dvhai08/Hawaco_datalogger/01.Docs/Other/ota_note.txt

Step1 :
chèn 16 bytes md5 vào cuối cùng firmware
step2: chèn header
DTG01 : 44544730310000000000000000000000
DTG02 : 44544730320000000000000000000000
Lưu ý : cài đặt version hardware trên web trùng với trên device
