dvhai08/Hawaco_datalogger/01.Docs/Other/9ddd6996b74a4114185b.jpg

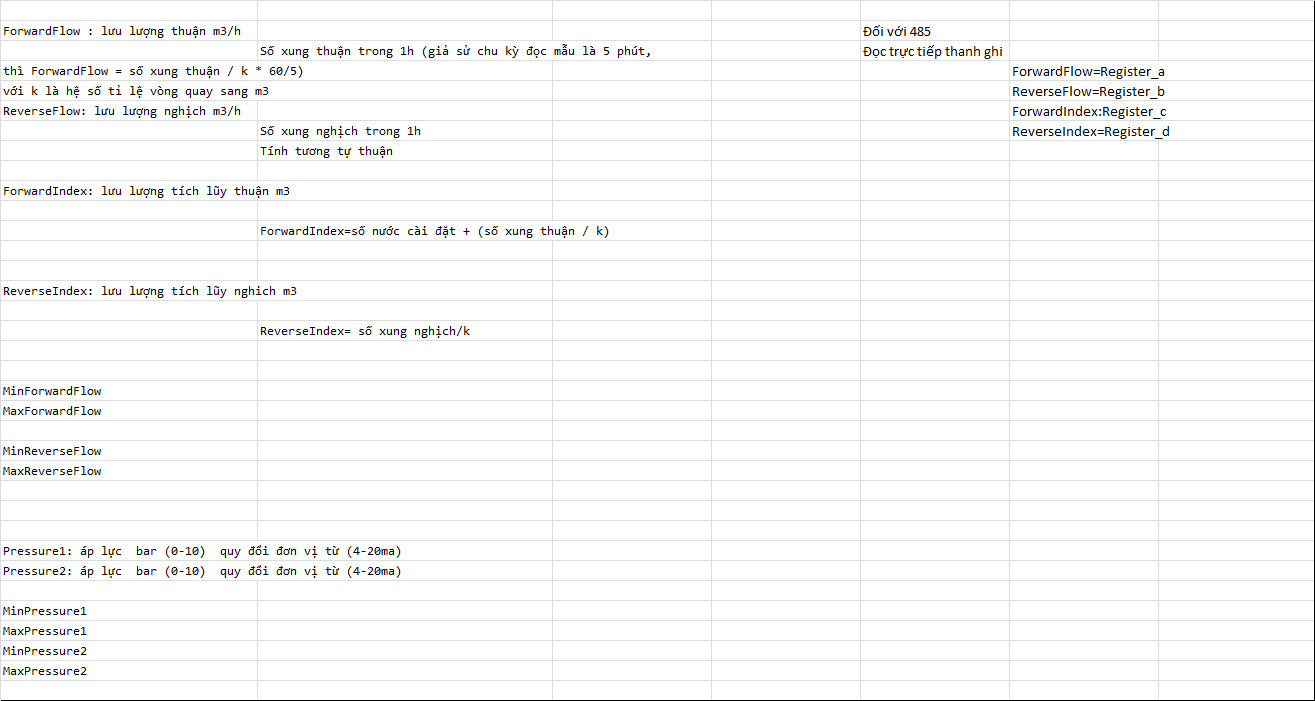
01.Docs/Other/9ddd6996b74a4114185b.jpg
