dvhai08/Hawaco_datalogger/(list of files, drawings)

Other design files:
03.Hardware/DT-G1/HAWACO_DATALOGER_DT-G1_V2.0 (6-12-2021 11-16-03 AM)/Prj/HAWACO_DATALOGER_DT-G1_V2.0.PrjPcb
03.Hardware/DT-G1/HAWACO_DATALOGER_DT-G1_V2.0 (6-12-2021 11-16-03 AM)/Sch/00. Root.SchDoc
03.Hardware/DT-G1/HAWACO_DATALOGER_DT-G1_V2.0 (6-12-2021 11-16-03 AM)/Sch/01. Cover.SchDoc
03.Hardware/DT-G1/HAWACO_DATALOGER_DT-G1_V2.0 (6-12-2021 11-16-03 AM)/Sch/02. Block diagram.SchDoc
03.Hardware/DT-G1/HAWACO_DATALOGER_DT-G1_V2.0 (6-12-2021 11-16-03 AM)/Sch/03. Power.SchDoc
03.Hardware/DT-G1/HAWACO_DATALOGER_DT-G1_V2.0 (6-12-2021 11-16-03 AM)/Sch/04. MCU + ANALOG.SchDoc
03.Hardware/DT-G1/HAWACO_DATALOGER_DT-G1_V2.0 (6-12-2021 11-16-03 AM)/Sch/05. 4G Module.SchDoc
03.Hardware/HAWACO_DATALOGER_DT-G2_V1.0 (6-12-2021 11-17-38 AM)/Prj/HAWACO_DATALOGER_DT-G2_V1.0.PrjPcb
03.Hardware/HAWACO_DATALOGER_DT-G2_V1.0 (6-12-2021 11-17-38 AM)/Sch/00. Root.SchDoc
03.Hardware/HAWACO_DATALOGER_DT-G2_V1.0 (6-12-2021 11-17-38 AM)/Sch/01. Cover.SchDoc
03.Hardware/HAWACO_DATALOGER_DT-G2_V1.0 (6-12-2021 11-17-38 AM)/Sch/03. Power.SchDoc
03.Hardware/HAWACO_DATALOGER_DT-G2_V1.0 (6-12-2021 11-17-38 AM)/Sch/04. MCU + ANALOG.SchDoc
03.Hardware/HAWACO_DATALOGER_DT-G2_V1.0 (6-12-2021 11-17-38 AM)/Sch/05. 4G Module.SchDoc
03.Hardware/HAWACO_DATALOGER_DT-G2_V1.0.2 (7-20-2021 3-44-25 PM)/Prj/HAWACO_DATALOGER_DT-G2_V1.0.2.PrjPcb
03.Hardware/HAWACO_DATALOGER_DT-G2_V1.0.2 (7-20-2021 3-44-25 PM)/Sch/00. Root.SchDoc
03.Hardware/HAWACO_DATALOGER_DT-G2_V1.0.2 (7-20-2021 3-44-25 PM)/Sch/01. Cover.SchDoc
03.Hardware/HAWACO_DATALOGER_DT-G2_V1.0.2 (7-20-2021 3-44-25 PM)/Sch/03. Power.SchDoc
03.Hardware/HAWACO_DATALOGER_DT-G2_V1.0.2 (7-20-2021 3-44-25 PM)/Sch/04. MCU + ANALOG.SchDoc
03.Hardware/HAWACO_DATALOGER_DT-G2_V1.0.2 (7-20-2021 3-44-25 PM)/Sch/05. 4G Module.SchDoc
03.Hardware/HAWACO_DATALOGER_DT-G2_V1.0.3 (8-11-2021 3-12-40 PM)/Pcb/HAWACO_DATALOGER_DT-G2_PANEL.PcbDoc
03.Hardware/HAWACO_DATALOGER_DT-G2_V1.0.3 (8-11-2021 3-12-40 PM)/Prj/HAWACO_DATALOGER_DT-G2_V1.0.3.PrjPcb
03.Hardware/HAWACO_DATALOGER_DT-G2_V1.0.3 (8-11-2021 3-12-40 PM)/Sch/00. Root.SchDoc
03.Hardware/HAWACO_DATALOGER_DT-G2_V1.0.3 (8-11-2021 3-12-40 PM)/Sch/01. Cover.SchDoc
03.Hardware/HAWACO_DATALOGER_DT-G2_V1.0.3 (8-11-2021 3-12-40 PM)/Sch/02. Block diagram.SchDoc
03.Hardware/HAWACO_DATALOGER_DT-G2_V1.0.3 (8-11-2021 3-12-40 PM)/Sch/03. Power.SchDoc
03.Hardware/HAWACO_DATALOGER_DT-G2_V1.0.3 (8-11-2021 3-12-40 PM)/Sch/04. MCU + ANALOG.SchDoc
03.Hardware/HAWACO_DATALOGER_DT-G2_V1.0.3 (8-11-2021 3-12-40 PM)/Sch/05. 4G Module.SchDoc
