dvhai08/Hawaco_datalogger/02.Firmware/src/inc/hardware.h

#ifndef __HARDWARE_H__
#define __HARDWARE_H__

#if 1
#include "main.h"
#ifndef DTG02V2
#define GSM_PWR_EN(x)			{	if (x) \
										LL_GPIO_SetOutputPin(GSM_EN_GPIO_Port, GSM_EN_Pin);	\
									else	\
										LL_GPIO_ResetOutputPin(GSM_EN_GPIO_Port, GSM_EN_Pin);	\
								}
#else
#define GSM_PWR_EN(x)			{	if (x) \
									{	\
										LL_GPIO_SetOutputPin(GSM_EN_GPIO_Port, GSM_EN_Pin);	\
										LL_GPIO_SetOutputPin(SYS_4V2_EN_GPIO_Port, SYS_4V2_EN_Pin);	\
									}	\
									else	\
									{	\
										LL_GPIO_ResetOutputPin(GSM_EN_GPIO_Port, GSM_EN_Pin);	\
									}	\
								}
#endif
#define GSM_PWR_RESET(x)		{	if (x) \
										LL_GPIO_SetOutputPin(GSM_RESET_GPIO_Port, GSM_RESET_Pin);	\
									else	\
										LL_GPIO_ResetOutputPin(GSM_RESET_GPIO_Port, GSM_RESET_Pin);	\
								}

#define GSM_PWR_KEY(x)			{	if (x) \
										LL_GPIO_SetOutputPin(GSM_PWR_KEY_GPIO_Port, GSM_PWR_KEY_Pin);	\
									else	\
										LL_GPIO_ResetOutputPin(GSM_PWR_KEY_GPIO_Port, GSM_PWR_KEY_Pin);	\
								}		

#define GSM_IS_PWR_EN()			LL_GPIO_IsOutputPinSet(GSM_EN_GPIO_Port, GSM_EN_Pin) ? 1 : 0

#define GSM_UART				0
#define RS485_UART				1

#ifdef HW_VERSION_0
#define LED1(x)             	{	if (x) \
										LL_GPIO_ResetOutputPin(LED1_GPIO_Port, LED1_Pin);	\
									else	\
										LL_GPIO_SetOutputPin(LED1_GPIO_Port, LED1_Pin);	\
								}		

#define LED2(x)             	{	if (x) \
										LL_GPIO_ResetOutputPin(LED2_GPIO_Port, LED2_Pin);	\
									else	\
										LL_GPIO_SetOutputPin(LED2_GPIO_Port, LED2_Pin);	\
									}	
#else
#define LED1(x)             	{	if (x) \
                                        LL_GPIO_SetOutputPin(LED1_GPIO_Port, LED1_Pin);	\
                                    else	\
                                        LL_GPIO_ResetOutputPin(LED1_GPIO_Port, LED1_Pin);	\
                                }		

#define LED2(x)             	{	if (x) \
										LL_GPIO_SetOutputPin(LED2_GPIO_Port, LED2_Pin);	\
									else	\
										LL_GPIO_ResetOutputPin(LED2_GPIO_Port, LED2_Pin);	\
                                }	
#define LED1_TOGGLE()			LL_GPIO_TogglePin(LED1_GPIO_Port, LED1_Pin)
#define LED2_TOGGLE()			LL_GPIO_TogglePin(LED2_GPIO_Port, LED2_Pin)							
#endif
				
#define TRANS_OUTPUT(x)      	{	if (x) \
										LL_GPIO_ResetOutputPin(TRANS_OUTPUT_GPIO_Port, TRANS_OUTPUT_Pin);	\
									else	\
										LL_GPIO_SetOutputPin(TRANS_OUTPUT_GPIO_Port, TRANS_OUTPUT_Pin);	\
								}	                                
							
#define TRANS_1_OUTPUT(x)      	{	if (x) \
										LL_GPIO_ResetOutputPin(TRANS_OUT1_GPIO_Port, TRANS_OUT1_Pin);	\
									else	\
										LL_GPIO_SetOutputPin(TRANS_OUT1_GPIO_Port, TRANS_OUT1_Pin);	\
								}	

#define TRANS_2_OUTPUT(x)      	{	if (x) \
										LL_GPIO_ResetOutputPin(TRANS_OUT2_GPIO_Port, TRANS_OUT2_Pin);	\
									else	\
										LL_GPIO_SetOutputPin(TRANS_OUT2_GPIO_Port, TRANS_OUT2_Pin);	\
								}	

#define TRANS_3_OUTPUT(x)      	{	if (x) \
										LL_GPIO_ResetOutputPin(TRANS_OUT3_GPIO_Port, TRANS_OUT3_Pin);	\
									else	\
										LL_GPIO_SetOutputPin(TRANS_OUT3_GPIO_Port, TRANS_OUT3_Pin);	\
								}	

#define TRANS_4_OUTPUT(x)      	{	if (x) \
										LL_GPIO_ResetOutputPin(TRANS_OUT4_GPIO_Port, TRANS_OUT4_Pin);	\
									else	\
										LL_GPIO_SetOutputPin(TRANS_OUT4_GPIO_Port, TRANS_OUT4_Pin);	\
								}								

#define TRANS_1_TOGGLE()      	{   \
										LL_GPIO_TogglePin(TRANS_OUT1_GPIO_Port, TRANS_OUT1_Pin);	\
								}	

#define TRANS_2_TOGGLE()      	{   \
										LL_GPIO_TogglePin(TRANS_OUT2_GPIO_Port, TRANS_OUT2_Pin);	\
								}	

#define TRANS_3_TOGGLE()      	{   \
										LL_GPIO_TogglePin(TRANS_OUT3_GPIO_Port, TRANS_OUT3_Pin);	\
								}	

#define TRANS_4_TOGGLE()      	{   \
										LL_GPIO_TogglePin(TRANS_OUT4_GPIO_Port, TRANS_OUT4_Pin);	\
								}	
                                
#define TRANS_IS_OUTPUT_HIGH()		(LL_GPIO_IsOutputPinSet(TRANS_OUTPUT_GPIO_Port, TRANS_OUTPUT_Pin) ? 0 : 1)
#define TRANS_1_IS_OUTPUT_HIGH()	(LL_GPIO_IsOutputPinSet(TRANS_OUT1_GPIO_Port, TRANS_OUT1_Pin) ? 0 : 1)
#define TRANS_2_IS_OUTPUT_HIGH()	(LL_GPIO_IsOutputPinSet(TRANS_OUT2_GPIO_Port, TRANS_OUT2_Pin) ? 0 : 1)

#define TRANS_3_IS_OUTPUT_HIGH()	(LL_GPIO_IsOutputPinSet(TRANS_OUT3_GPIO_Port, TRANS_OUT3_Pin) ? 0 : 1)
#define TRANS_4_IS_OUTPUT_HIGH()	(LL_GPIO_IsOutputPinSet(TRANS_OUT4_GPIO_Port, TRANS_OUT4_Pin) ? 0 : 1)
								
#define ENABLE_NTC_POWER(x)     {	if (x) \
										LL_GPIO_SetOutputPin(VNTC_GPIO_Port, VNTC_Pin);	\
									else	\
										LL_GPIO_ResetOutputPin(VNTC_GPIO_Port, VNTC_Pin);	\
								}		

#define NTC_IS_POWERED()		LL_GPIO_IsOutputPinSet(VNTC_GPIO_Port, VNTC_Pin)						
								
								
#define ENABLE_INPUT_4_20MA_POWER(x)	{	if (x) \
												LL_GPIO_ResetOutputPin(EN_4_20MA_IN_GPIO_Port, EN_4_20MA_IN_Pin);	\
											else	\
												LL_GPIO_SetOutputPin(EN_4_20MA_IN_GPIO_Port, EN_4_20MA_IN_Pin);	\
										}

#define INPUT_POWER_4_20_MA_IS_ENABLE()       (LL_GPIO_IsOutputPinSet(EN_4_20MA_IN_GPIO_Port, EN_4_20MA_IN_Pin) ? 0 : 1)
         
#ifdef DTG01										
    #define ENABLE_OUTPUT_4_20MA_POWER(x)	{	if (x) \
                                                    LL_GPIO_ResetOutputPin(ENABLE_OUTPUT_4_20MA_GPIO_Port, ENABLE_OUTPUT_4_20MA_Pin);	\
                                                else	\
                                                    LL_GPIO_SetOutputPin(ENABLE_OUTPUT_4_20MA_GPIO_Port, ENABLE_OUTPUT_4_20MA_Pin);	\
                                            }	
#endif  // DTG01

#if defined(DTG02V2)  
                                        
    // 4.2V provice power for GSM and 4-20mA ouput
    #define ENABLE_OUTPUT_4_20MA_POWER(x)	{	if (x) \
                                                    LL_GPIO_SetOutputPin(SYS_4V2_EN_GPIO_Port, SYS_4V2_EN_Pin);	\
                                                else if (gsm_data_layer_is_module_sleeping())	\
                                                    LL_GPIO_ResetOutputPin(SYS_4V2_EN_GPIO_Port, SYS_4V2_EN_Pin);	\
                                            }	
    #define ENABLE_SYS_4V2(x)				{	if (x) \
                                                    LL_GPIO_SetOutputPin(SYS_4V2_EN_GPIO_Port, SYS_4V2_EN_Pin);	\
                                                else	\
                                                    LL_GPIO_ResetOutputPin(SYS_4V2_EN_GPIO_Port, SYS_4V2_EN_Pin);	\
                                            }	
#endif // defined(DTG02V2) 
             
#if defined(DTG02)
                                        
    // 4.2V provice power for GSM and 4-20mA ouput
    #define ENABLE_OUTPUT_4_20MA_POWER(x)	{	if (x) \
                                                    LL_GPIO_SetOutputPin(ENABLE_OUTPUT_4_20MA_GPIO_Port, ENABLE_OUTPUT_4_20MA_Pin);	\
                                                else if (gsm_data_layer_is_module_sleeping())	\
                                                    LL_GPIO_ResetOutputPin(ENABLE_OUTPUT_4_20MA_GPIO_Port, ENABLE_OUTPUT_4_20MA_Pin);	\
                                            }	
    #define ENABLE_SYS_4V2(x)				{	if (x) \
                                                    LL_GPIO_SetOutputPin(ENABLE_OUTPUT_4_20MA_GPIO_Port, ENABLE_OUTPUT_4_20MA_Pin);	\
                                                else	\
                                                    LL_GPIO_ResetOutputPin(ENABLE_OUTPUT_4_20MA_GPIO_Port, ENABLE_OUTPUT_4_20MA_Pin);	\
                                            }	
#endif // defined(DTG02)                                          
                                            


#if defined(DTG02V3)  
                                        
    // 4.2V provice power for GSM and 4-20mA ouput
    #define ENABLE_OUTPUT_4_20MA_POWER(x)	{	if (x) \
                                                    LL_GPIO_ResetOutputPin(EN_4_20MA_OUT_POWER_GPIO_Port, EN_4_20MA_OUT_POWER_Pin);	\
                                                else	\
                                                    LL_GPIO_SetOutputPin(EN_4_20MA_OUT_POWER_GPIO_Port, EN_4_20MA_OUT_POWER_Pin);	\
                                            }
        
    #define ENABLE_SYS_4V2(x)				{	if (x) \
                                                    LL_GPIO_SetOutputPin(SYS_5V_EN_GPIO_Port, SYS_5V_EN_Pin);	\
                                                else	\
                                                    LL_GPIO_ResetOutputPin(SYS_5V_EN_GPIO_Port, SYS_5V_EN_Pin);	\
                                            }	
#endif // defined(DTG02V3) 
										
#define RS485_POWER_EN(x)				{	if (x) \
												LL_GPIO_ResetOutputPin(RS485_EN_GPIO_Port, RS485_EN_Pin);	\
											else	\
												LL_GPIO_SetOutputPin(RS485_EN_GPIO_Port, RS485_EN_Pin);	\
										}	
#define RS485_DIR_TX()                  {   \
                                            LL_GPIO_SetOutputPin(RS485_DIR_GPIO_Port, RS485_DIR_Pin);     \
                                        }
   
#define RS485_DIR_RX()                  {   \
                                            LL_GPIO_ResetOutputPin(RS485_DIR_GPIO_Port, RS485_DIR_Pin);     \
                                        }                                        
#define RS485_GET_DIRECTION()               LL_GPIO_IsOutputPinSet(RS485_DIR_GPIO_Port, RS485_DIR_Pin)
#endif

#ifdef DTG02
#define BUZZER(x)                       {	if (x) \
												LL_GPIO_ResetOutputPin(BUZZER_GPIO_Port, BUZZER_Pin);	\
											else	\
												LL_GPIO_SetOutputPin(BUZZER_GPIO_Port, BUZZER_Pin);	\
										}   
#endif                                        
                                        
#define ADC_NUMBER_OF_CONVERSION_TIMES		10
//#define V_OFFSET_4_20MA_CHANNEL_0_MV        1
#define ADC_VBAT_RESISTOR_DIV				2
#define ADC_VIN_RESISTOR_DIV				7911
#define ADC_VI_ANALOG_INPUT_RESISTOR_DIV    7667
                                        
#ifdef DTG02
#define ADC_CHANNEL_DMA_COUNT				9
//#define ADC_VREF							3300

#define V_INPUT_3_4_20MA_CHANNEL_INDEX		0
#define VIN_24V_CHANNEL_INDEX				1
#define V_INPUT_2_4_20MA_CHANNEL_INDEX		2
#define V_INPUT_1_4_20MA_CHANNEL_INDEX		3
#define V_INPUT_0_4_20MA_CHANNEL_INDEX		4
#define VBAT_CHANNEL_INDEX					5
#define V_NTC_TEMP_CHANNEL_INDEX				6
#define V_INTERNAL_CHIP_TEMP_CHANNEL_INDEX  7
#define V_REF_CHANNEL_INDEX                 8
//#define V_OFFSET_4_20MA_CHANNEL_1_MV        1
//#define V_OFFSET_4_20MA_CHANNEL_2_MV        1
//#define V_OFFSET_4_20MA_CHANNEL_3_MV        1
#endif

#ifdef DTG02V2
#define ADC_CHANNEL_DMA_COUNT				9
//#define ADC_VREF							3300

#define V_INPUT_3_4_20MA_CHANNEL_INDEX		5
#define VIN_24V_CHANNEL_INDEX				0
#define V_INPUT_2_4_20MA_CHANNEL_INDEX		1
#define V_INPUT_1_4_20MA_CHANNEL_INDEX		2
#define V_INPUT_0_4_20MA_CHANNEL_INDEX		3
#define VBAT_CHANNEL_INDEX					4
#define V_NTC_TEMP_CHANNEL_INDEX		    6
#define V_INTERNAL_CHIP_TEMP_CHANNEL_INDEX  7
#define V_REF_CHANNEL_INDEX                 8
#endif /* DTG02V2 */

#ifdef DTG02V3
#define ADC_CHANNEL_DMA_COUNT				11
#define V_ANALOG_0_INPUT_INDEX              1
#define V_ANALOG_1_INPUT_INDEX              5
#define VIN_24V_CHANNEL_INDEX				0

#define V_INPUT_3_4_20MA_CHANNEL_INDEX		7
#define V_INPUT_2_4_20MA_CHANNEL_INDEX		2
#define V_INPUT_1_4_20MA_CHANNEL_INDEX		3
#define V_INPUT_0_4_20MA_CHANNEL_INDEX		4

#define VBAT_CHANNEL_INDEX					6
#define V_NTC_TEMP_CHANNEL_INDEX		    8

#define V_INTERNAL_CHIP_TEMP_CHANNEL_INDEX  9
#define V_REF_CHANNEL_INDEX                 10
#endif /* DTG02V3 */

#ifdef DTG01
#define ADC_CHANNEL_DMA_COUNT				6
//#define ADC_VREF							3300

#define VBAT_CHANNEL_INDEX						0
#define V_INPUT_0_4_20MA_CHANNEL_INDEX			1
#define VIN_24V_CHANNEL_INDEX					2	
#define V_NTC_TEMP_CHANNEL_INDEX				3
#define V_INTERNAL_CHIP_TEMP_CHANNEL_INDEX  	4
#define V_REF_CHANNEL_INDEX						5
#endif

#define VREF_OFFSET_MV							80
#define ADC_INPUT_4_20MA_GAIN               	(50.0f)   



#if defined(DTG02) || defined(DTG02V2) || defined(DTG02V3)
    #define NUMBER_OF_INPUT_4_20MA						4
    #define MEASURE_NUMBER_OF_WATER_METER_INPUT			2
    
    #ifdef DTG02V3
        #define NUMBER_OF_OUTPUT_ON_OFF						2
    #else
        #define NUMBER_OF_OUTPUT_ON_OFF						4
    #endif
    
    #define NUMBER_OF_OUTPUT_4_20MA                     1
    
    #if defined(DTG02)
        #define MEASURE_INPUT_PORT_1						0
        #define MEASURE_INPUT_PORT_2		                1
        #define	NUMBER_OF_INPUT_ON_OFF						4
    #elif defined(DTG02V2)
        #define MEASURE_INPUT_PORT_1						1
        #define MEASURE_INPUT_PORT_2		                0
        #define	NUMBER_OF_INPUT_ON_OFF						4
    #elif defined(DTG02V3)
        #define MEASURE_INPUT_PORT_1						0
        #define MEASURE_INPUT_PORT_2		                1
        #define	NUMBER_OF_INPUT_ON_OFF						2
    #endif
#else   // DTG01
    #define MEASURE_INPUT_PORT_1						0
    #define MEASURE_INPUT_PORT_2		                1
    #define	NUMBER_OF_OUTPUT_ON_OFF						1
    #define NUMBER_OF_INPUT_4_20MA						1
    #define NUMBER_OF_OUTPUT_4_20MA                     1
    #define MEASURE_NUMBER_OF_WATER_METER_INPUT			1		
#endif // defined(DTG02) || defined(DTG02V2) || defined(DTG02V3)

#define MEASURE_INPUT_NEW_DATA_TYPE_PWM_PIN         0
#define MEASURE_INPUT_NEW_DATA_TYPE_DIR_PIN         1
#define MEASUREMENT_MAX_MSQ_IN_RAM                  1

#define MEASUREMENT_QUEUE_STATE_IDLE                0
#define MEASUREMENT_QUEUE_STATE_PENDING             1       // Dang cho de doc
#define MEASUREMENT_QUEUE_STATE_PROCESSING          2       // Da doc nhung dang xu li, chua release thanh free

#define RS485_DATA_TYPE_INT16						0
#define RS485_DATA_TYPE_INT32						1
#define RS485_DATA_TYPE_FLOAT						2
#define RS485_MAX_SLAVE_ON_BUS						1
#define RS485_MAX_REGISTER_SUPPORT					4
#define RS485_MAX_SUB_REGISTER						4
#define RS485_REGISTER_ADDR_TOP						50000

#define APP_EEPROM_VALID_FLAG						0x15234519
#define APP_EEPROM_SIZE								(6*1024)

#define APP_EEPROM_METER_MODE_DISABLE				0
#define APP_EEPROM_METER_MODE_PWM_PLUS_DIR_MIN		1 // Meter mode 0 : PWM++, DIR--
#define APP_EEPROM_METER_MODE_ONLY_PWM				2 // Meter mode 1 : PWM++
#define APP_EEPROM_METER_MODE_PWM_F_PWM_R			3 // Meter mode 2 : PWM_F & PWM_R
#define APP_EEPROM_METER_MODE_MAX_ELEMENT           2
#define APP_EEPROM_MAX_PHONE_LENGTH                 16
#define APP_EEPROM_MAX_SERVER_ADDR_LENGTH           64
#define APP_EEPROM_MAX_NUMBER_OF_SERVER				2
#define APP_EEPROM_MAIN_SERVER_ADDR_INDEX			0
#define APP_EEPROM_ALTERNATIVE_SERVER_ADDR_INDEX	(APP_EEPROM_MAX_NUMBER_OF_SERVER-1)

#if defined(DTG02) || defined(DTG02V2) || defined(DTG02V3)
    #define APP_EEPROM_NB_OF_INPUT_4_20MA               4
#else
    #define APP_EEPROM_NB_OF_INPUT_4_20MA               1
#endif // defined(DTG02) || defined(DTG02V2) || defined(DTG02V3)

#define APP_EEPROM_MAX_UNIT_NAME_LENGTH				6

#define APP_FLASH_VALID_DATA_KEY                    0x12345678               
#ifdef DTG01
#define APP_FLASH_NB_OFF_4_20MA_INPUT               2
#define APP_FLASH_NB_OF_METER_INPUT                 1
#else
#define APP_FLASH_NB_OFF_4_20MA_INPUT               NUMBER_OF_INPUT_4_20MA
#define APP_FLASH_NB_OF_METER_INPUT                 APP_EEPROM_METER_MODE_MAX_ELEMENT
#endif
#define APP_FLASH_RS485_MAX_SIZE                    (RS485_MAX_REGISTER_SUPPORT)
#define APP_SPI_FLASH_SIZE						    (1024*1024)
#define APP_FLASH_DONT_NEED_TO_SEND_TO_SERVER_FLAG  0xA5A5A5A5
//#define APP_FLASH_DATA_HEADER_KEY                   0x9813567A

#define CRC32_SIZE		4

#define INPUT_ON_OFF_0()			(LL_GPIO_IsInputPinSet(OPTOIN1_GPIO_Port, OPTOIN1_Pin) ? 1 : 0)
#define INPUT_ON_OFF_1()			(LL_GPIO_IsInputPinSet(OPTOIN2_GPIO_Port, OPTOIN2_Pin) ? 1 : 0)
#define INPUT_ON_OFF_2()			(LL_GPIO_IsInputPinSet(OPTOIN3_GPIO_Port, OPTOIN3_Pin) ? 1 : 0)
#define INPUT_ON_OFF_3()			(LL_GPIO_IsInputPinSet(OPTOIN4_GPIO_Port, OPTOIN4_Pin) ? 1 : 0)

#define FLOW_INVALID_VALUE                  (-1.0f)
#define INPUT_4_20MA_INVALID_VALUE          (-1.0f)
#define INPUT_485_INVALID_FLOAT_VALUE       (-1.0f)    
#define INPUT_485_INVALID_INT_VALUE         (-1)    

#define FAKE_MIN_MAX_DATA                   (0)
#define USE_SYNC_DRV                        (0)

#define MEASURE_SUM_MB_FLOW                 0

typedef union
{
	struct
	{
		uint8_t valid : 1;
		uint8_t type : 7;
	} __attribute__((packed)) name;
	uint8_t raw;
} __attribute__((packed)) measure_input_rs485_data_type_t;

typedef union
{
    float float_val;
    int32_t int32_val;
    uint8_t raw[4];
} __attribute__((packed)) measure_input_rs485_float_uint32_t;

typedef struct
{
	uint16_t register_addr;
	measure_input_rs485_float_uint32_t value;
	measure_input_rs485_data_type_t data_type;
	uint8_t unit[APP_EEPROM_MAX_UNIT_NAME_LENGTH];
	int8_t read_ok;
} __attribute__((packed)) measure_input_rs485_sub_register_t;

typedef union
{
    int32_t type_int32;
    float type_float;
    uint8_t raw[4];
} __attribute__((packed)) min_max_485_type_t;
typedef struct
{
    min_max_485_type_t min_forward_flow;
    min_max_485_type_t max_forward_flow;
    min_max_485_type_t min_reverse_flow;
    min_max_485_type_t max_reverse_flow;
    min_max_485_type_t reverse_flow;
    min_max_485_type_t forward_flow;
#if MEASURE_SUM_MB_FLOW
    min_max_485_type_t forward_flow_sum;
    min_max_485_type_t reverse_flow_sum;
#endif
    min_max_485_type_t net_volume_fw;
    min_max_485_type_t net_volume_reverse;
    min_max_485_type_t net_speed;
    min_max_485_type_t net_index;
    uint8_t valid;
} __attribute__((packed)) measure_input_rs485_min_max_t;
typedef struct
{
	measure_input_rs485_sub_register_t sub_register[RS485_MAX_SUB_REGISTER];
    measure_input_rs485_min_max_t min_max;
    uint16_t fw_flow_reg;
    uint16_t reserve_flow_reg;
    uint16_t net_totalizer_fw_reg;
    uint16_t net_totalizer_reverse_reg;
    uint16_t net_totalizer_reg;
    uint8_t slave_addr;
} __attribute__((packed)) measure_input_modbus_register_t;

typedef struct
{
    float fw_flow_min;
    float fw_flow_max;
    float reserve_flow_min;
    float reserve_flow_max;
    uint32_t fw_flow_first_counter;
    uint32_t reverse_flow_first_counter;
    float fw_flow_sum;
    float reverse_flow_sum;
    uint8_t valid;
} __attribute__((packed)) flow_hour_t;

typedef struct
{
    float input4_20ma_min;
    float input4_20ma_max;
    uint8_t valid;
} __attribute__((packed)) input_4_20ma_min_max_hour_t;

typedef struct
{
	int32_t real_counter;           // gia tri do khi da tinh ca xung am duong
    int32_t reverse_counter;
    int32_t total_forward;
    int32_t total_reverse;
    
    uint32_t fw_flow;               // Toc do quay thuan
    uint32_t reverse_flow;          // Toc do quay nguoc
    
    float flow_speed_forward_agv_cycle_wakeup;             // Trung binh toc do giua 2 lan do 
    float flow_speed_reserve_agv_cycle_wakeup;             // Trung binh toc do giua 2 lan do 
    
    uint32_t total_forward_index;       // So nuoc thuan da tinh khi chia cho k + offset
    uint32_t total_reverse_index;       // so nuoc nghich da tinh sau khi chia cho k (ko co offset)
    
    flow_hour_t flow_avg_cycle_send_web;        // Trung binh toc do giua 2 lan thuc day gui data len web
    
    uint32_t indicator;
	uint16_t k;
	uint8_t mode;
	uint8_t cir_break;
} __attribute__((packed)) measure_input_counter_t;

typedef struct
{
    uint32_t current_ma_mil_10;		// 4ma =>> 400
    int32_t adc_mv;					    // adc voltage
} input_4_20ma_lookup_t;

typedef struct
{
	uint32_t round_per_sec_max;
	uint32_t round_per_sec_min;
} __attribute__((packed)) speed_limit_t;

typedef struct
{
	uint32_t tick;
	uint32_t isr_type;
} pulse_irq_t;

static const input_4_20ma_lookup_t lookup_table_4_20ma_input[] =
{
    {  0,        400      },
    {  400,      490    },
    {  500,      591    },  
    {  600,      688    },   
    {  710,      800    },     
    {  800,      890    },    
    {  900,      992    },    
    {  1100,     1098   },  
    {  1290,     1385   },    
    {  1525,     1617   },     
    {  1823,     1915   },     
    {  2000,     2100   },
};
                                  
                                  
#endif /* __HARDWARE_H__ */
