dvhai08/Hawaco_datalogger/02.Firmware/DTG02_V3/Core/Src/adc.c

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
/* Includes ------------------------------------------------------------------*/
#include "adc.h"

/* USER CODE BEGIN 0 */
#include "app_debug.h"
#include <stdbool.h>
#include "lpf.h"
#include "hardware.h"
#include "app_eeprom.h"
#include "math.h"
#include "sys_ctx.h"
#include <string.h>
#include "jig.h"

#define ADC_INPUT_4_20MA_MIN_OFFSET_MV  27
#define ADC_INPUT_4_20MA_MAX_OFFSET_MV  150
#define ADC_VIN_DIODE_OFFSET            220

enum { NUM_CURRENT_LOOK_UP = sizeof(lookup_table_4_20ma_input) / sizeof(input_4_20ma_lookup_t) };

static volatile bool m_adc_started = false;
volatile uint16_t m_adc_raw_data[ADC_CHANNEL_DMA_COUNT];
lpf_data_t m_adc_filterd_data[ADC_CHANNEL_DMA_COUNT];
uint16_t offset_input_4_20ma_mv[APP_EEPROM_NB_OF_INPUT_4_20MA];
static bool m_is_the_first_time = true;

static float look_up_current(uint32_t mv)        // 0.4mA =>> 4, 4mA >> 
{
#if 0
    uint32_t i;
    // Check input min or max
    if (mv <=  lookup_table_4_20ma_input[0].adc_mv)
    {
        return 0;
    }
    else if (mv >=  lookup_table_4_20ma_input[NUM_CURRENT_LOOK_UP-1].adc_mv)
    {
        return 2000;     // 20mA
    }
    
    for (i = 0; i < NUM_CURRENT_LOOK_UP; i++)
    {
        if (mv >= lookup_table_4_20ma_input[i].adc_mv
            && mv < lookup_table_4_20ma_input[i+1].adc_mv)
        {
            uint32_t diff_mv = lookup_table_4_20ma_input[i+1].adc_mv - lookup_table_4_20ma_input[i].adc_mv;
            uint32_t diff_ma = lookup_table_4_20ma_input[i+1].current_ma_mil_10 - lookup_table_4_20ma_input[i].current_ma_mil_10;
            uint32_t ma = lookup_table_4_20ma_input[i].current_ma_mil_10 + diff_ma*(mv - lookup_table_4_20ma_input[i].adc_mv)/diff_mv;
            return ma;
        }
    }

    return 0;
#else
    return mv/ADC_INPUT_4_20MA_GAIN;
#endif
}

/* USER CODE END 0 */

/* ADC init function */
void MX_ADC_Init(void)
{

  /* USER CODE BEGIN ADC_Init 0 */
    if (m_is_the_first_time)
    {
        memset(offset_input_4_20ma_mv, 0, sizeof(offset_input_4_20ma_mv));
    }
  /* USER CODE END ADC_Init 0 */

  LL_ADC_REG_InitTypeDef ADC_REG_InitStruct = {0};
  LL_ADC_InitTypeDef ADC_InitStruct = {0};

  LL_GPIO_InitTypeDef GPIO_InitStruct = {0};

  /* Peripheral clock enable */
  LL_APB2_GRP1_EnableClock(LL_APB2_GRP1_PERIPH_ADC1);

  LL_IOP_GRP1_EnableClock(LL_IOP_GRP1_PERIPH_GPIOC);
  LL_IOP_GRP1_EnableClock(LL_IOP_GRP1_PERIPH_GPIOA);
  /**ADC GPIO Configuration
  PC0   ------> ADC_IN10
  PC1   ------> ADC_IN11
  PC3   ------> ADC_IN13
  PA1   ------> ADC_IN1
  PA4   ------> ADC_IN4
  PA5   ------> ADC_IN5
  PA6   ------> ADC_IN6
  PA7   ------> ADC_IN7
  PC5   ------> ADC_IN15
  */
  GPIO_InitStruct.Pin = ADC_IO_IN0_Pin;
  GPIO_InitStruct.Mode = LL_GPIO_MODE_ANALOG;
  GPIO_InitStruct.Pull = LL_GPIO_PULL_NO;
  LL_GPIO_Init(ADC_IO_IN0_GPIO_Port, &GPIO_InitStruct);

  GPIO_InitStruct.Pin = ADC_VBAT_Pin;
  GPIO_InitStruct.Mode = LL_GPIO_MODE_ANALOG;
  GPIO_InitStruct.Pull = LL_GPIO_PULL_NO;
  LL_GPIO_Init(ADC_VBAT_GPIO_Port, &GPIO_InitStruct);

  GPIO_InitStruct.Pin = ADC_4_20MA_IN4_Pin;
  GPIO_InitStruct.Mode = LL_GPIO_MODE_ANALOG;
  GPIO_InitStruct.Pull = LL_GPIO_PULL_NO;
  LL_GPIO_Init(ADC_4_20MA_IN4_GPIO_Port, &GPIO_InitStruct);

  GPIO_InitStruct.Pin = ADC_24V_Pin;
  GPIO_InitStruct.Mode = LL_GPIO_MODE_ANALOG;
  GPIO_InitStruct.Pull = LL_GPIO_PULL_NO;
  LL_GPIO_Init(ADC_24V_GPIO_Port, &GPIO_InitStruct);

  GPIO_InitStruct.Pin = ADC_IO_IN1_Pin;
  GPIO_InitStruct.Mode = LL_GPIO_MODE_ANALOG;
  GPIO_InitStruct.Pull = LL_GPIO_PULL_NO;
  LL_GPIO_Init(ADC_IO_IN1_GPIO_Port, &GPIO_InitStruct);

  GPIO_InitStruct.Pin = ADC_4_20MA_IN3_Pin;
  GPIO_InitStruct.Mode = LL_GPIO_MODE_ANALOG;
  GPIO_InitStruct.Pull = LL_GPIO_PULL_NO;
  LL_GPIO_Init(ADC_4_20MA_IN3_GPIO_Port, &GPIO_InitStruct);

  GPIO_InitStruct.Pin = ADC_4_20MA_IN3A6_Pin;
  GPIO_InitStruct.Mode = LL_GPIO_MODE_ANALOG;
  GPIO_InitStruct.Pull = LL_GPIO_PULL_NO;
  LL_GPIO_Init(ADC_4_20MA_IN3A6_GPIO_Port, &GPIO_InitStruct);

  GPIO_InitStruct.Pin = ADC_4_20MA_IN1_Pin;
  GPIO_InitStruct.Mode = LL_GPIO_MODE_ANALOG;
  GPIO_InitStruct.Pull = LL_GPIO_PULL_NO;
  LL_GPIO_Init(ADC_4_20MA_IN1_GPIO_Port, &GPIO_InitStruct);

  GPIO_InitStruct.Pin = ADC_VTEMP_Pin;
  GPIO_InitStruct.Mode = LL_GPIO_MODE_ANALOG;
  GPIO_InitStruct.Pull = LL_GPIO_PULL_NO;
  LL_GPIO_Init(ADC_VTEMP_GPIO_Port, &GPIO_InitStruct);

  /* USER CODE BEGIN ADC_Init 1 */
  if (SystemCoreClock > 8000000)
  {
        LL_ADC_SetCommonClock(__LL_ADC_COMMON_INSTANCE(ADC1), LL_ADC_CLOCK_ASYNC_DIV12);
  }
  else
  {
      LL_ADC_SetCommonClock(__LL_ADC_COMMON_INSTANCE(ADC1), LL_ADC_CLOCK_ASYNC_DIV1);
  }
  /* USER CODE END ADC_Init 1 */
  /** Configure Regular Channel
  */
  LL_ADC_REG_SetSequencerChAdd(ADC1, LL_ADC_CHANNEL_1);
  /** Configure Regular Channel
  */
  LL_ADC_REG_SetSequencerChAdd(ADC1, LL_ADC_CHANNEL_4);
  /** Configure Regular Channel
  */
  LL_ADC_REG_SetSequencerChAdd(ADC1, LL_ADC_CHANNEL_5);
  /** Configure Regular Channel
  */
  LL_ADC_REG_SetSequencerChAdd(ADC1, LL_ADC_CHANNEL_6);
  /** Configure Regular Channel
  */
  LL_ADC_REG_SetSequencerChAdd(ADC1, LL_ADC_CHANNEL_7);
  /** Configure Regular Channel
  */
  LL_ADC_REG_SetSequencerChAdd(ADC1, LL_ADC_CHANNEL_10);
  /** Configure Regular Channel
  */
  LL_ADC_REG_SetSequencerChAdd(ADC1, LL_ADC_CHANNEL_11);
  /** Configure Regular Channel
  */
  LL_ADC_REG_SetSequencerChAdd(ADC1, LL_ADC_CHANNEL_13);
  /** Configure Regular Channel
  */
  LL_ADC_REG_SetSequencerChAdd(ADC1, LL_ADC_CHANNEL_15);
  /** Configure Regular Channel
  */
  LL_ADC_REG_SetSequencerChAdd(ADC1, LL_ADC_CHANNEL_TEMPSENSOR);
  LL_ADC_SetCommonPathInternalCh(__LL_ADC_COMMON_INSTANCE(ADC1), LL_ADC_PATH_INTERNAL_TEMPSENSOR);
  /** Configure Regular Channel
  */
  LL_ADC_REG_SetSequencerChAdd(ADC1, LL_ADC_CHANNEL_VREFINT);
  LL_ADC_SetCommonPathInternalCh(__LL_ADC_COMMON_INSTANCE(ADC1), LL_ADC_PATH_INTERNAL_VREFINT);
  /** Common config
  */
  ADC_REG_InitStruct.TriggerSource = LL_ADC_REG_TRIG_SOFTWARE;
  ADC_REG_InitStruct.SequencerDiscont = LL_ADC_REG_SEQ_DISCONT_DISABLE;
  ADC_REG_InitStruct.ContinuousMode = LL_ADC_REG_CONV_SINGLE;
  ADC_REG_InitStruct.DMATransfer = LL_ADC_REG_DMA_TRANSFER_NONE;
  ADC_REG_InitStruct.Overrun = LL_ADC_REG_OVR_DATA_PRESERVED;
  LL_ADC_REG_Init(ADC1, &ADC_REG_InitStruct);
  LL_ADC_SetSamplingTimeCommonChannels(ADC1, LL_ADC_SAMPLINGTIME_160CYCLES_5);
  LL_ADC_SetOverSamplingScope(ADC1, LL_ADC_OVS_DISABLE);
  LL_ADC_REG_SetSequencerScanDirection(ADC1, LL_ADC_REG_SEQ_SCAN_DIR_FORWARD);
  LL_ADC_SetCommonFrequencyMode(__LL_ADC_COMMON_INSTANCE(ADC1), LL_ADC_CLOCK_FREQ_MODE_HIGH);
  LL_ADC_DisableIT_EOC(ADC1);
  LL_ADC_DisableIT_EOS(ADC1);
  ADC_InitStruct.Clock = LL_ADC_CLOCK_SYNC_PCLK_DIV1;
  ADC_InitStruct.Resolution = LL_ADC_RESOLUTION_12B;
  ADC_InitStruct.DataAlignment = LL_ADC_DATA_ALIGN_RIGHT;
  ADC_InitStruct.LowPowerMode = LL_ADC_LP_MODE_NONE;
  LL_ADC_Init(ADC1, &ADC_InitStruct);

  /* Enable ADC internal voltage regulator */
  LL_ADC_EnableInternalRegulator(ADC1);
  /* Delay for ADC internal voltage regulator stabilization. */
  /* Compute number of CPU cycles to wait for, from delay in us. */
  /* Note: Variable divided by 2 to compensate partially */
  /* CPU processing cycles (depends on compilation optimization). */
  /* Note: If system core clock frequency is below 200kHz, wait time */
  /* is only a few CPU processing cycles. */
  uint32_t wait_loop_index;
  wait_loop_index = ((LL_ADC_DELAY_INTERNAL_REGUL_STAB_US * (SystemCoreClock / (100000 * 2))) / 10);
  while(wait_loop_index != 0)
  {
    wait_loop_index--;
  }
  /* USER CODE BEGIN ADC_Init 2 */
  
//    if (LL_ADC_IsEnabled(ADC1) == 0)
    {
        /* Run ADC self calibration */
        LL_ADC_StartCalibration(ADC1);

        /* Poll for ADC effectively calibrated */
        #if (USE_TIMEOUT == 1)
        Timeout = ADC_CALIBRATION_TIMEOUT_MS;
        #endif /* USE_TIMEOUT */
        
        while (LL_ADC_IsCalibrationOnGoing(ADC1) != 0)
        {
        #if (USE_TIMEOUT == 1)
          /* Check Systick counter flag to decrement the time-out value */
          if (LL_SYSTICK_IsActiveCounterFlag())
          {
            if(Timeout-- == 0)
            {
            /* Time-out occurred. Set LED to blinking mode */
            LED_Blinking(LED_BLINK_ERROR);
            }
          }
        #endif /* USE_TIMEOUT */
        }
    }
    
//    LL_ADC_EnableIT_EOC(ADC1);
    // Clear the ADRDY bit in ADC_ISR register by programming this bit to 1.
	SET_BIT(ADC1->ISR, LL_ADC_FLAG_ADRDY);
    LL_ADC_Enable(ADC1);
    while (LL_ADC_IsActiveFlag_ADRDY(ADC1) == 0);
  /* USER CODE END ADC_Init 2 */

}

/* USER CODE BEGIN 1 */
void adc_isr_cb(void)
{
    /* Check whether ADC group regular end of unitary conversion caused         */
    /* the ADC interruption.                                                    */
    if(LL_ADC_IsActiveFlag_EOC(ADC1) != 0)
    {
        /* Clear flag ADC group regular end of unitary conversion */
        LL_ADC_ClearFlag_EOC(ADC1);

    }

    /* Check whether ADC group regular overrun caused the ADC interruption */
    if(LL_ADC_IsActiveFlag_OVR(ADC1) != 0)
    {
        DEBUG_ERROR("ADC overrun\r\n");
        LL_ADC_ClearFlag_OVR(ADC1);
    }
}

void adc_start()
{
    app_eeprom_config_data_t * cfg = app_eeprom_read_config_data();
	
#ifdef DTG01
    if (cfg->io_enable.name.input_4_20ma_0_enable || m_is_the_first_time)
#else
	if (cfg->io_enable.name.input_4_20ma_0_enable
		|| cfg->io_enable.name.input_4_20ma_1_enable
		|| cfg->io_enable.name.input_4_20ma_2_enable
		|| cfg->io_enable.name.input_4_20ma_3_enable
		|| m_is_the_first_time)
#endif
    {
//        ENABLE_INPUT_4_20MA_POWER(1);
//        if (m_is_the_first_time)
//        {
//            sys_delay_ms(2000);     // time for input 4-20ma stable
//        }
//        else
//        {
//            sys_delay_ms(2);
//        }
    }
    else if (jig_is_in_test_mode())
    {
		ENABLE_INPUT_4_20MA_POWER(1);
    }
	else
	{
		ENABLE_INPUT_4_20MA_POWER(0);
	}
#ifndef USE_INTERNAL_VREF    
    if (!NTC_IS_POWERED())
    {
        ENABLE_NTC_POWER(1);
    }
#else
    ENABLE_NTC_POWER(0);
#endif
    if (LL_ADC_IsEnabled(ADC1) == 0)
    {
        MX_ADC_Init();
    }
    
    // Reset all adc value
    for (uint32_t i = 0; i < ADC_CHANNEL_DMA_COUNT; i++)
    {
        m_adc_raw_data[i] = 0;
    }
    
    // Start convert ADC channel
    for (uint32_t j = 0; j < ADC_NUMBER_OF_CONVERSION_TIMES; j++)
    {
        for (uint32_t i = 0; i < ADC_CHANNEL_DMA_COUNT; i++)
        {
            if (i == 0)
            {
                LL_ADC_REG_SetSequencerChannels(ADC1, LL_ADC_CHANNEL_1);
            }
            else if (i == 1)
            {
                LL_ADC_REG_SetSequencerChannels(ADC1, LL_ADC_CHANNEL_4);
            }
            else if (i == 2)
            {
                LL_ADC_REG_SetSequencerChannels(ADC1, LL_ADC_CHANNEL_5);
            }
            else if (i == 3)
            {
                LL_ADC_REG_SetSequencerChannels(ADC1, LL_ADC_CHANNEL_6);
            }
            else if (i == 4)
            {
                LL_ADC_REG_SetSequencerChannels(ADC1, LL_ADC_CHANNEL_7); 
            }
            else if (i == 5)
            {
                LL_ADC_REG_SetSequencerChannels(ADC1, LL_ADC_CHANNEL_10);            
            }
            else if (i == 6)
            {
                LL_ADC_REG_SetSequencerChannels(ADC1, LL_ADC_CHANNEL_11);            
            }
            else if (i == 7)
            {
                LL_ADC_REG_SetSequencerChannels(ADC1, LL_ADC_CHANNEL_13); 
            }
            else if (i == 8)
            {
                LL_ADC_REG_SetSequencerChannels(ADC1, LL_ADC_CHANNEL_15); 
            }
            else if (i == 9)
            {
                LL_ADC_REG_SetSequencerChannels(ADC1, LL_ADC_CHANNEL_TEMPSENSOR);      
                LL_ADC_SetCommonPathInternalCh(__LL_ADC_COMMON_INSTANCE(ADC1), LL_ADC_PATH_INTERNAL_TEMPSENSOR);                
            }
            else if (i == 10)
            {
                LL_ADC_REG_SetSequencerChannels(ADC1, LL_ADC_CHANNEL_VREFINT);
                LL_ADC_SetCommonPathInternalCh(__LL_ADC_COMMON_INSTANCE(ADC1), LL_ADC_PATH_INTERNAL_VREFINT); 
            }

            
            if (LL_ADC_REG_IsConversionOngoing(ADC1) == 0)
            {
                LL_ADC_REG_StartConversion(ADC1);
            }
            while (LL_ADC_REG_IsConversionOngoing(ADC1))
            {
//                __WFI();
            }
            m_adc_raw_data[i] += LL_ADC_REG_ReadConversionData12(ADC1);
        }
    }
    // Get avg adc data
    for (uint32_t i = 0; i < ADC_CHANNEL_DMA_COUNT; i++)
    {
        m_adc_raw_data[i] /= ADC_NUMBER_OF_CONVERSION_TIMES;
    }
    
    // If in test mode =>> always turn on input 4-20ma power
    if (sys_ctx()->status.is_enter_test_mode || jig_is_in_test_mode())
    {
        ENABLE_INPUT_4_20MA_POWER(1);   
    }
    else
    {
        ENABLE_INPUT_4_20MA_POWER(0);
    }
    adc_convert();
}

void adc_stop(void)
{
	ENABLE_NTC_POWER(0);
//    NVIC_DisableIRQ(ADC1_COMP_IRQn);
    LL_ADC_DeInit(ADC1);
    LL_ADC_DisableInternalRegulator(ADC1);
    LL_APB2_GRP1_DisableClock(LL_APB2_GRP1_PERIPH_ADC1);
}

// Voi DTG02, ta su dung vbat la v_acqui
static uint8_t convert_vin_to_percent(uint32_t vin)
{
#define VIN_MAX 13800
#define VIN_MIN 10500

    if (vin >= VIN_MAX)
        return 100;
    if (vin <= VIN_MIN)
        return 0;
    return ((vin - VIN_MIN) * 100) / (VIN_MAX - VIN_MIN);
}
#ifndef USE_INTERNAL_VREF
static bool convert_temperature(uint32_t vtemp_mv, uint32_t vbat_mv, int32_t *result)
{
#ifndef DTG02V3
    #define HW_RESISTOR_SERIES_NTC 10000 //10K Ohm
#else
    #define HW_RESISTOR_SERIES_NTC 200000 //10K Ohm
#endif
    /* This is thermistor dependent and it should be in the datasheet, or refer to the
    article for how to calculate it using the Beta equation.
    I had to do this, but I would try to get a thermistor with a known
    beta if you want to avoid empirical calculations. */
    #define BETA 4570.0f //B25/B75

    /* This is also needed for the conversion equation as "typical" room temperature
    is needed as an input. */
    #define ROOM_TEMP 298.15f // room temperature in Kelvin

    /* Thermistors will have a typical resistance at room temperature so write this 
    down here. Again, needed for conversion equations. */
    #define RESISTOR_ROOM_TEMP 10000.0f //Resistance in Ohms @ 25oC	330k/470k

    bool retval = true;
    float vtemp_float;
    float vbat_float;
    float r_ntc;
    float temp ;
    
    if(vtemp_mv == vbat_mv
        || vtemp_mv == 0)
    {
        retval = false;
        goto end;
    }

    //NTC ADC: Vntc1 = Vntc2 = Vin
    //Tinh dien ap NTC
    vtemp_float = vtemp_mv / 1000.0f;
    vbat_float = vbat_mv / 1000.0f;

    //Caculate NTC resistor : Vntc = Vin*Rs/(Rs + Rntc) -> Rntc = Rs(Vin/Vntc - 1)
    r_ntc = HW_RESISTOR_SERIES_NTC*(vbat_float/vtemp_float - 1);

    if (r_ntc <= 0)
    {
        retval = false;
        goto end;
    }

    temp = (BETA * ROOM_TEMP) / (BETA + (ROOM_TEMP * log(r_ntc / RESISTOR_ROOM_TEMP))) - 273.15f;

    if (temp < 0)
    {
        retval = false;
        goto end;
    }

    *result = (int32_t)temp;
end:
    return retval;
}
#endif

adc_input_value_t m_adc_input;

adc_input_value_t *adc_get_input_result(void)
{
	return &m_adc_input;
}

void adc_convert(void)
{	
    // Get VREF and VDDA
    m_adc_input.vref_int = *((uint16_t*)0x1FF80078);
	// m_adc_input.vdda_mv = 3000 * m_adc_input.vref_int/m_adc_raw_data[V_REF_CHANNEL_INDEX] + VREF_OFFSET_MV;
    m_adc_input.vdda_mv = __LL_ADC_CALC_VREFANALOG_VOLTAGE(m_adc_raw_data[V_REF_CHANNEL_INDEX], LL_ADC_RESOLUTION_12B);
//    DEBUG_VERBOSE("VDDA %umv\r\n", m_adc_input.vdda_mv);
    
	/* ADC Vbat 4.2V */
	m_adc_input.bat_mv = (ADC_VBAT_RESISTOR_DIV*m_adc_raw_data[VBAT_CHANNEL_INDEX]*m_adc_input.vdda_mv/4095);
    
    /* ADC Vin 24V */
	m_adc_input.vin = ((uint32_t)ADC_VIN_RESISTOR_DIV*m_adc_raw_data[VIN_24V_CHANNEL_INDEX]/(uint32_t)1000)*m_adc_input.vdda_mv/4095;
    if (m_adc_input.vin > 1000)
    {
        m_adc_input.vin += ADC_VIN_DIODE_OFFSET;
    }
    m_adc_input.bat_percent = convert_vin_to_percent(m_adc_input.vin);
    
    // Analog
    uint32_t tmp = 0;
    tmp = ADC_VI_ANALOG_INPUT_RESISTOR_DIV*m_adc_raw_data[V_ANALOG_0_INPUT_INDEX]*m_adc_input.vdda_mv/4095;
    m_adc_input.analog_input_io[0] = tmp;
    tmp = ADC_VI_ANALOG_INPUT_RESISTOR_DIV*m_adc_raw_data[V_ANALOG_1_INPUT_INDEX]*m_adc_input.vdda_mv/4095;
    m_adc_input.analog_input_io[1] = tmp;
    
    
    /* Get 4-20mA input channel to mv */
    
    // Channel 0
    m_adc_raw_data[V_INPUT_0_4_20MA_CHANNEL_INDEX] = m_adc_raw_data[V_INPUT_0_4_20MA_CHANNEL_INDEX]*m_adc_input.vdda_mv/4095;
    if (m_is_the_first_time 
        && (m_adc_raw_data[V_INPUT_0_4_20MA_CHANNEL_INDEX] < ADC_INPUT_4_20MA_MAX_OFFSET_MV)
        && (m_adc_raw_data[V_INPUT_0_4_20MA_CHANNEL_INDEX] > ADC_INPUT_4_20MA_MIN_OFFSET_MV))
    {
        offset_input_4_20ma_mv[0] = m_adc_raw_data[V_INPUT_0_4_20MA_CHANNEL_INDEX];
    }
    if (m_adc_raw_data[V_INPUT_0_4_20MA_CHANNEL_INDEX] >= offset_input_4_20ma_mv[0])
    {
//        m_adc_raw_data[V_INPUT_0_4_20MA_CHANNEL_INDEX] -= offset_input_4_20ma_mv[0];
    }
    else
    {
        m_adc_raw_data[V_INPUT_0_4_20MA_CHANNEL_INDEX] = 0;
    }
//    DEBUG_VERBOSE("[IN0 4-20] %umv, offset %umv\r\n", m_adc_raw_data[V_INPUT_0_4_20MA_CHANNEL_INDEX], offset_input_4_20ma_mv[0]); 
    
#if 1
    // Channel 1
    m_adc_raw_data[V_INPUT_1_4_20MA_CHANNEL_INDEX] = m_adc_raw_data[V_INPUT_1_4_20MA_CHANNEL_INDEX]*m_adc_input.vdda_mv/4095;
    if (m_is_the_first_time 
        && (m_adc_raw_data[V_INPUT_1_4_20MA_CHANNEL_INDEX] < ADC_INPUT_4_20MA_MAX_OFFSET_MV)
        && (m_adc_raw_data[V_INPUT_1_4_20MA_CHANNEL_INDEX] > ADC_INPUT_4_20MA_MIN_OFFSET_MV))
    {
        offset_input_4_20ma_mv[1] = m_adc_raw_data[V_INPUT_1_4_20MA_CHANNEL_INDEX];
    }
    if (m_adc_raw_data[V_INPUT_1_4_20MA_CHANNEL_INDEX] >= offset_input_4_20ma_mv[1])
    {
//        m_adc_raw_data[V_INPUT_1_4_20MA_CHANNEL_INDEX] -= offset_input_4_20ma_mv[1];
    }
    else
    {
        m_adc_raw_data[V_INPUT_1_4_20MA_CHANNEL_INDEX] = 0;
    }
//    DEBUG_VERBOSE("[IN1 4-20] %umv, offset %umv\r\n", m_adc_raw_data[V_INPUT_1_4_20MA_CHANNEL_INDEX], offset_input_4_20ma_mv[1]); 
    
    
    // Channel 2
    if (m_is_the_first_time 
        && (m_adc_raw_data[V_INPUT_2_4_20MA_CHANNEL_INDEX] < ADC_INPUT_4_20MA_MAX_OFFSET_MV)
        && (m_adc_raw_data[V_INPUT_2_4_20MA_CHANNEL_INDEX] > ADC_INPUT_4_20MA_MIN_OFFSET_MV))
    {
        offset_input_4_20ma_mv[2] = m_adc_raw_data[V_INPUT_2_4_20MA_CHANNEL_INDEX];
    }
    m_adc_raw_data[V_INPUT_2_4_20MA_CHANNEL_INDEX] = m_adc_raw_data[V_INPUT_2_4_20MA_CHANNEL_INDEX]*m_adc_input.vdda_mv/4095;
    if (m_adc_raw_data[V_INPUT_2_4_20MA_CHANNEL_INDEX] >= offset_input_4_20ma_mv[2])
    {
//        m_adc_raw_data[V_INPUT_2_4_20MA_CHANNEL_INDEX] -= offset_input_4_20ma_mv[2];
    }
    else
    {
        m_adc_raw_data[V_INPUT_2_4_20MA_CHANNEL_INDEX] = 0;
    }
//    DEBUG_VERBOSE("[IN2 4-20] %umv, offset %umv\r\n", m_adc_raw_data[V_INPUT_2_4_20MA_CHANNEL_INDEX], offset_input_4_20ma_mv[2]); 
    
    // 4-20ma channel 3
    m_adc_raw_data[V_INPUT_3_4_20MA_CHANNEL_INDEX] = m_adc_raw_data[V_INPUT_3_4_20MA_CHANNEL_INDEX]*m_adc_input.vdda_mv/4095;
    if (m_is_the_first_time 
        && (m_adc_raw_data[V_INPUT_3_4_20MA_CHANNEL_INDEX] < ADC_INPUT_4_20MA_MAX_OFFSET_MV)
        && (m_adc_raw_data[V_INPUT_3_4_20MA_CHANNEL_INDEX] > ADC_INPUT_4_20MA_MIN_OFFSET_MV))
    {
        offset_input_4_20ma_mv[3] = m_adc_raw_data[V_INPUT_3_4_20MA_CHANNEL_INDEX];
//        m_adc_raw_data[V_INPUT_3_4_20MA_CHANNEL_INDEX] -= offset_input_4_20ma_mv[3];
    }
    if (m_adc_raw_data[V_INPUT_3_4_20MA_CHANNEL_INDEX] >= offset_input_4_20ma_mv[3])
    {
//        m_adc_raw_data[V_INPUT_3_4_20MA_CHANNEL_INDEX] -= offset_input_4_20ma_mv[3];
    }
    else
    {
        m_adc_raw_data[V_INPUT_3_4_20MA_CHANNEL_INDEX] = 0;
    }
//    DEBUG_VERBOSE("[IN3 4-20] %umv, offset %umv\r\n", m_adc_raw_data[V_INPUT_3_4_20MA_CHANNEL_INDEX], offset_input_4_20ma_mv[3]); 
    
#endif
    
    // Get final 4-20mA value, 4.5mA ->> x10 =  45
    if (m_is_the_first_time == false)
    {
        m_adc_input.in_4_20ma_in[0] = look_up_current(m_adc_raw_data[V_INPUT_0_4_20MA_CHANNEL_INDEX]);
    }
    else
    {
        m_adc_input.in_4_20ma_in[0] = 0;
        sys_delay_ms(100);
    }

#if 1
    if (m_is_the_first_time == false)
    {
        m_adc_input.in_4_20ma_in[1] = look_up_current(m_adc_raw_data[V_INPUT_1_4_20MA_CHANNEL_INDEX]);
        m_adc_input.in_4_20ma_in[2] = look_up_current(m_adc_raw_data[V_INPUT_2_4_20MA_CHANNEL_INDEX]);
        m_adc_input.in_4_20ma_in[3] = look_up_current(m_adc_raw_data[V_INPUT_3_4_20MA_CHANNEL_INDEX]);
    }
    else
    {
        m_adc_input.in_4_20ma_in[1] = 0;
        m_adc_input.in_4_20ma_in[2] = 0;
        m_adc_input.in_4_20ma_in[3] = 0;
    }
    
//    if (sys_ctx()->status.is_enter_test_mode)
//    {
//		static uint32_t last_print = 0;
//		uint32_t now = sys_get_ms();
//		
//		if (now - last_print > 1000)
//		{
//			for (uint8_t i = 0; i < 4; i++)
//			{
//				DEBUG_WARN("IN%u, current %.2fmA\r\n", i, m_adc_input.in_4_20ma_in[i]); 
//			}
//			last_print = now;
//		}
//    }
#endif

    /* Temperature */
#ifndef USE_INTERNAL_VREF
	/* v_temp */
    if (m_adc_raw_data[V_NTC_TEMP_CHANNEL_INDEX])
    {
        uint32_t vtemp_mv = m_adc_raw_data[V_NTC_TEMP_CHANNEL_INDEX]*m_adc_input.vdda_mv/4095;
        if (convert_temperature(vtemp_mv, m_adc_input.vdda_mv, &m_adc_input.temp))
        {
            m_adc_input.temp_is_valid = 1;
        }
        else
        {
            m_adc_input.temp_is_valid = 0;
        }
    }
#else
    m_adc_input.temp_is_valid = 1;
    m_adc_input.temp = __LL_ADC_CALC_TEMPERATURE(m_adc_input.vdda_mv, m_adc_raw_data[V_INTERNAL_CHIP_TEMP_CHANNEL_INDEX], LL_ADC_RESOLUTION_12B);
#endif
    
    
    m_is_the_first_time = false;
}

/* USER CODE END 1 */
