dvhai08/Hawaco_datalogger/(commit log)

2021-05-13 Commit after working day
    [Data fomat datalogger (1).xlsx]
2021-05-14 fix mqtt rx bug
    [DataDefine.h, GSM_DataLayer.c, main.c]
2021-05-14 Fix gsm sleep and wakeup bug
    [GSM_DataLayer.c, app_bkup.c, main.c]
2021-05-14 bug in sleep function
    [GSM_DataLayer.c, main.c]
2021-05-15 too much current
2021-05-16 rtc exti line 17
    [Current consumption.xlsx]
2021-05-18 Release phase 1, current 400uA
    [Data fomat datalogger.xlsx]
2021-05-19 Put sensor data every thoi_gian_do
2021-05-19 store data
    [Data fomat datalogger (2).xlsx]
2021-05-20 fix small bug
    [Estimate.xlsx]
2021-05-30 Bug in gsm msg
    [gsm_data_layer.c, server_msg.c, server_msg.h]
2021-06-09 bug in gsm http
    [gsm_data_layer.c, gsm_hardware_layer.c, gsm_http.c]
2021-06-10 http ok
    [Estimate.xlsx]
2021-06-12 port to stm32
2021-06-12 fix dma tx
2021-06-15 add flash
    [Data fomat datalogger_ByTech,PLC comment (1).xlsx]
2021-06-15 add ext flash
    [Data fomat datalogger (1).xlsx, Data fomat datalogger (2).xlsx, Data fomat datalogger.xlsx]
2021-06-17 update code
    [00. Root.SchDoc, 01. Cover.SchDoc, 02. Block diagram.SchDoc, 03. Power.SchDoc, 04. MCU + ANALOG.SchDoc, 05. 4G Module.SchDoc, Estimate.xlsx, HAWACO_DATALOGER_DT-G2_PANEL.PcbDoc]
2021-06-21 update rtc module
    [Estimate.xlsx, Estimate_DTG1.xlsx, Estimate_DTG2.xlsx]
2021-06-23 bug adc
2021-06-23 adc bug
2021-06-24 update pwm to dac
2021-06-24 rs485 work
    [note.xlsx]
2021-06-25 fix usart and dma bug
    [DataDefine.h, app_eeprom.h, app_rtc.c, app_rtc.h, gsm.h, gsm_data_layer.c]
2021-06-25 bug in backup register
    [app_bkup.c, app_rtc.c, measure_input.c]
2021-06-26 fix flash addr bug
    [app_cli.c, app_flash.c, app_rtc.c, gsm_data_layer.c, gsm_hardware_layer.c, gsm_http.c, gsm_sms.c, main.c]
2021-06-28 bug in spi
2021-06-29 bug in spi flash
    [app_cli.c, app_spi_flash.c, app_spi_flash.h, gsm_data_layer.c, main.c]
2021-06-30 support adc msq
2021-07-01 adc ok
2021-07-01 fix adc
2021-07-02 bug in power
2021-07-02 update spi flash
2021-07-02 power ok
    Please turn off debug low power mode
2021-07-02 fix adc bug
2021-07-03 update debug and fix bug in sensor
    [measure_input.c]
2021-07-04 measure input pulse ok
    [Estimate_DTG1.xlsx]
2021-07-04 fix line detect bug
    [measure_input.c]
2021-07-04 fix bug device not init data for the first time
    [app_eeprom.c, main.c, measure_input.c, server_msg.c]
2021-07-05 fix bug gsm http host
    [app_eeprom.c, gsm_data_layer.c, main.c]
2021-07-05 fix bug auto increase counter
    [gsm_data_layer.c, measure_input.c, server_msg.c]
2021-07-05 Fix bug
    [Danh sach id.xlsx]
2021-07-05 fix bug clk 4-20mA out
    [tim.c]
2021-07-06 update high bat
    [Current consumption.xlsx, Estimate.xlsx, Estimate_DTG1.xlsx]
2021-07-06 fix bug in adc
    [adc.c, control_output.c, hardware.h]
2021-07-06 fix dtg adc bug
    [main.c]
2021-07-07 update more dtg msg
    [Data fomat datalogger_ByTech,PLC comment (1).xlsx, Data fomat datalogger_ByTech,PLC comment.xlsx]
2021-07-07 handle more msg
    [Data fomat datalogger_ByTech,PLC comment.xlsx]
2021-07-08 dtg2 use ntc resister
2021-07-17 Fix bug send interval is wrong
    [gsm_data_layer.c]
2021-07-17 fix wakeup time is invalid
    [gsm_data_layer.c, main.c]
2021-07-18 fix bug in timestamp
    [gsm_data_layer.c]
2021-07-19 disable low power
2021-07-20 fix loi esim ko the kick hoat
    [adc.c, gsm.h, gsm_data_layer.c, main.c, measure_input.c, measure_input.h, server_msg.c]
2021-07-20 fix wrong value in flash
    [app_bkup.c, gsm_data_layer.c, gsm_http.c, main.c, measure_input.c, measure_input.h, server_msg.c]
2021-07-20 fix bug in measure input
    [measure_input.c, server_msg.c]
2021-07-21 update 4-20ma value
2021-07-21 optimize memory footprint
2021-07-22 fix bug in modbus
    [app_eeprom.c, gsm_data_layer.c, main.c, measure_input.c, rtc.c, server_msg.c, usart.c]
2021-07-27 fix bug power high on dtg02
    [00. Root.SchDoc, 01. Cover.SchDoc, 02. Block diagram.SchDoc, 03. Power.SchDoc, 04. MCU + ANALOG.SchDoc, 05. 4G Module.SchDoc, HAWACO_DATALOGER_DT-G2_PANEL.PcbDoc, HAWACO_DATALOGER_DT-G2_V1.0.2.PrjPcb]
2021-07-27 bug fix : DTG02 dung vin lam battery percent de gui len server
    [gsm_data_layer.c]
2021-07-31 cai lai win
    [04. MCU + ANALOG.SchDoc, Estimate_DTG2.xlsx]
2021-08-03 fix wrong pulse bug
    [app_bkup.c, main.c, measure_input.c, version_control.h]
2021-08-05 update rs485
    [00. Root.SchDoc, 01. Cover.SchDoc, 02. Block diagram.SchDoc, 03. Power.SchDoc, 04. MCU + ANALOG.SchDoc, 05. 4G Module.SchDoc, Danh sach id.xlsx, Data fomat datalogger_ByTech,PLC comment.xlsx]
2021-08-06 rs485 ok
    [Data fomat datalogger_ByTech,PLC comment.xlsx]
2021-08-07 update note
    [Data fomat datalogger_ByTech,PLC comment.xlsx]
2021-08-07 boot loader have 4 ma current
2021-08-08 fix input 4-20mA measurement
    [Data fomat datalogger_ByTech,PLC comment.xlsx]
2021-08-08 reduce 4-20mA delay time
2021-08-08 fix bug handle request 4-20mA from server
    [app_cli.c, gsm.h, gsm_sms.c, main.c, measure_input.c]
2021-08-09 fix 1 hardwawe err
    [gsm_data_layer.c]
2021-08-20 fix bug measure pulse counter
    [app_eeprom.c, app_eeprom.h, gsm_data_layer.c, hardware.h, main.c, measure_input.c, server_msg.c, version_control.h]
2021-08-21 fix new server bug
    [app_spi_flash.c, gsm_data_layer.c, hardware.h, main.c, measure_input.c, server_msg.c]
2021-08-21 fix bug report wrong output value
    [app_spi_flash.h, gsm_data_layer.c, hardware.h, measure_input.c, measure_input.h, server_msg.c, version_control.h]
2021-08-30 fix bug resend to server
    [hardware.h, measure_input.c]
2021-08-30 init DTG02 hardware v2
    [00. Root.SchDoc, 01. Cover.SchDoc, 02. Block diagram.SchDoc, 03. Power.SchDoc, 04. MCU + ANALOG.SchDoc, 05. 4G Module.SchDoc, HAWACO_DATALOGER_DT-G2_PANEL.PcbDoc, HAWACO_DATALOGER_DT-G2_V1.0.3.PrjPcb]
2021-09-06 increase time off gsm
    for stable adc convert
2021-09-09 fix spi flash bug
    [adc.c, app_eeprom.h, app_spi_flash.c, gsm_data_layer.c, hardware.h, main.c, measure_input.c]
2021-09-19 fix bug wakeup flash
    [app_cli.c, app_eeprom.h, app_spi_flash.c, gsm_data_layer.c, main.c, measure_input.c, server_msg.c]
2021-09-19 fix bug indicator does not reset
    [main.c, measure_input.c, version_control.h]
2021-09-19 fix bug measure input
    [app_bkup.c, app_spi_flash.c, app_spi_flash.h, gsm_data_layer.c, gsm_hardware_layer.c, measure_input.c, server_msg.c, version_control.h]
2021-09-20 fix register offset and update DTG02V2 bootloader
    [adc.c, adc.h, crc.c, crc.h, hardware.h]
2021-09-21 fix bug rtc cannot inti
    [adc.c, adc.h, app_cli.c, bootloader_gsm.c, crc.c, crc.h, gsm_data_layer.c]
2021-09-24 fix bug in dtg02 485
    [app_eeprom.h, app_spi_flash.c, main.c, version_control.h]
2021-09-26 static alocator memory and fix bug spi re-transmission
    [adc.c, app_spi_flash.c, gsm_data_layer.c, hardware.h, main.c, measure_input.c, server_msg.c]
2021-09-27 fix bootloader flash-ram function
    [gsm_data_layer.c, main.c, measure_input.c, version_control.h]
2021-09-28 update DTG01
    [G2_lan2.xlsx]
2021-10-01 update docs
    [G2_lan2.xlsx]
2021-11-11 fix bug flow mode 3 not working
    [gsm_data_layer.c, hardware.h, measure_input.c, ota_update.h, version_control.h]
2021-11-12 fix bug device not charge
    [gsm_data_layer.c, main.c, measure_input.c, ota_update.h, version_control.h]
2021-11-13 fix bug vadc input and charge
    [adc.c, adc.h, app_bkup.c, app_rtc.c, app_rtc.h, gsm_data_layer.c, main.c]
2021-11-15 x10 pressure
2021-11-15 bug fix : reload total forward and flow when device perform ota update
    [gsm_data_layer.c, hardware.h, measure_input.c]
2021-11-15 fix bug total index not recovery from flash
    [adc.c, adc.h, app_cli.c, gsm_data_layer.c, main.c, measure_input.c, ota_update.c, server_msg.c]
2021-11-15 update 485 baudrate configuration and send 485 error code to cloud
    [app_cli.c, app_eeprom.c, app_eeprom.h, gsm_data_layer.c, main.c, measure_input.c, measure_input.h, ota_update.h]
2021-11-23 change 485 flow data to float
2021-11-23 support sum mb flow
2021-11-23 support net and reverse flow
    [gsm_data_layer.c, hardware.h, measure_input.c, ota_update.h, server_msg.c, version_control.h]
2021-11-24 bug in mb flow
    [measure_input.c, ota_update.h, version_control.h]
2021-11-24 bug in pulse flow
    [gsm_data_layer.c, hardware.h, measure_input.c, ota_update.h, version_control.h]
2021-11-24 maybe mobus net flow bug in the slave count and slave in bus variable
    [measure_input.c, ota_update.h, version_control.h]
2021-11-24 fix bug modbus net flow
    [gsm_data_layer.c, measure_input.c, ota_update.h, version_control.h]
2021-11-25 fix 4-20mA min max value
    [gsm_data_layer.c, hardware.h, measure_input.c]
2021-12-07 Please review again power seq of dtg02v3
2021-12-07 update charger control
2021-12-07 please think about charge
2021-12-09 fix mb for dtg02
    [adc.c, adc.h, app_cli.c, gsm_data_layer.c, gsm_hardware_layer.c, hardware.h, main.c]
2021-12-09 fix bug data type in modbus
    [gsm_data_layer.c, measure_input.c, server_msg.c, version_control.h]
2021-12-09 update analog input voltage of dtg02v3
