dvhai08/Hawaco_datalogger/(notices)

Notices in the files:
02.Firmware/DTG02V3_JIG/Core/Src/main.c:
© Copyright (c) 2021 STMicroelectronics.
All rights reserved.
This software component is licensed by ST under Ultimate Liberty license
02.Firmware/DTG02_V3/Core/Src/adc.c:
Copyright (c) 2021 STMicroelectronics.
This software is licensed under terms that can be found in the LICENSE file
02.Firmware/DTG02_V3/Core/Inc/main.h:
This software component is licensed by ST under BSD 3-Clause license,
the "License"; You may not use this file except in compliance with the
License. You may obtain a copy of the License at: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
